DitroniX/CMIS-Current-Monitor-IoT-System/Datasheets and Information/README.md

**CMIS ESP32 Current Monitor IoT Sensors**

------------

This folder contains applicable datasheets and CMIS design information.

Further information can be found:

- **Website** https://ditronix.net/
- **WIKI**  https://ditronix.net/wiki/
- **GitHub**  https://github.com/DitroniX/
- **Shop**  https://ditronix.net/shop/

Dave Williams | G8PUO | DitroniX 1981-2024 | ditronix.net
