DitroniX/CMIS-Current-Monitor-IoT-System/Datasheets and Information/CMIS ESP32 SDK v1 2211-105 PCB 3D Bottom Angled.png

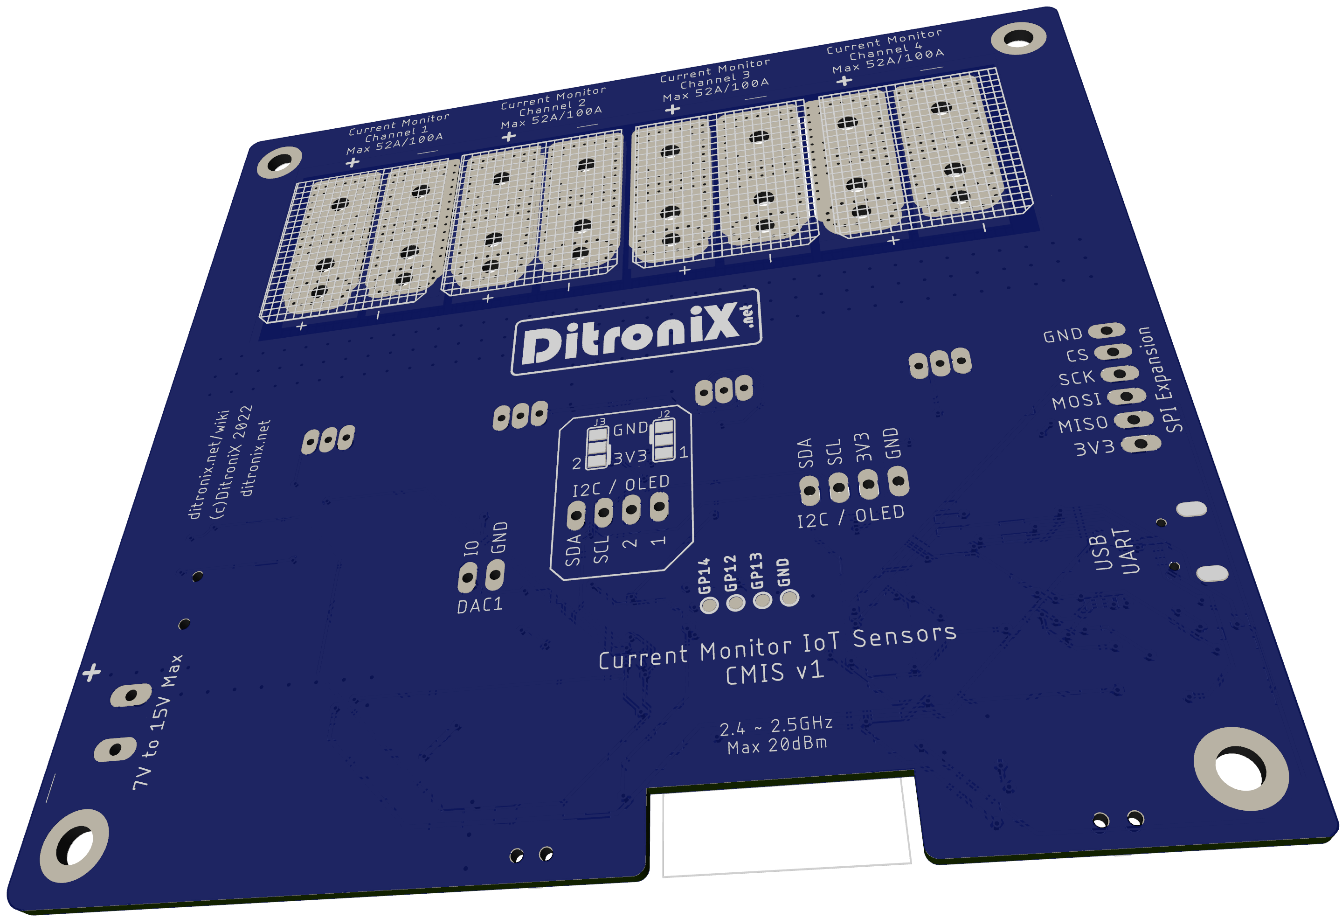
Datasheets and Information/CMIS ESP32 SDK v1 2211-105 PCB 3D Bottom Angled.png
