DitroniX/CMIS-Current-Monitor-IoT-System/Datasheets and Information/CMIS ESP32 SDK v1 2211-105 Schematic.png

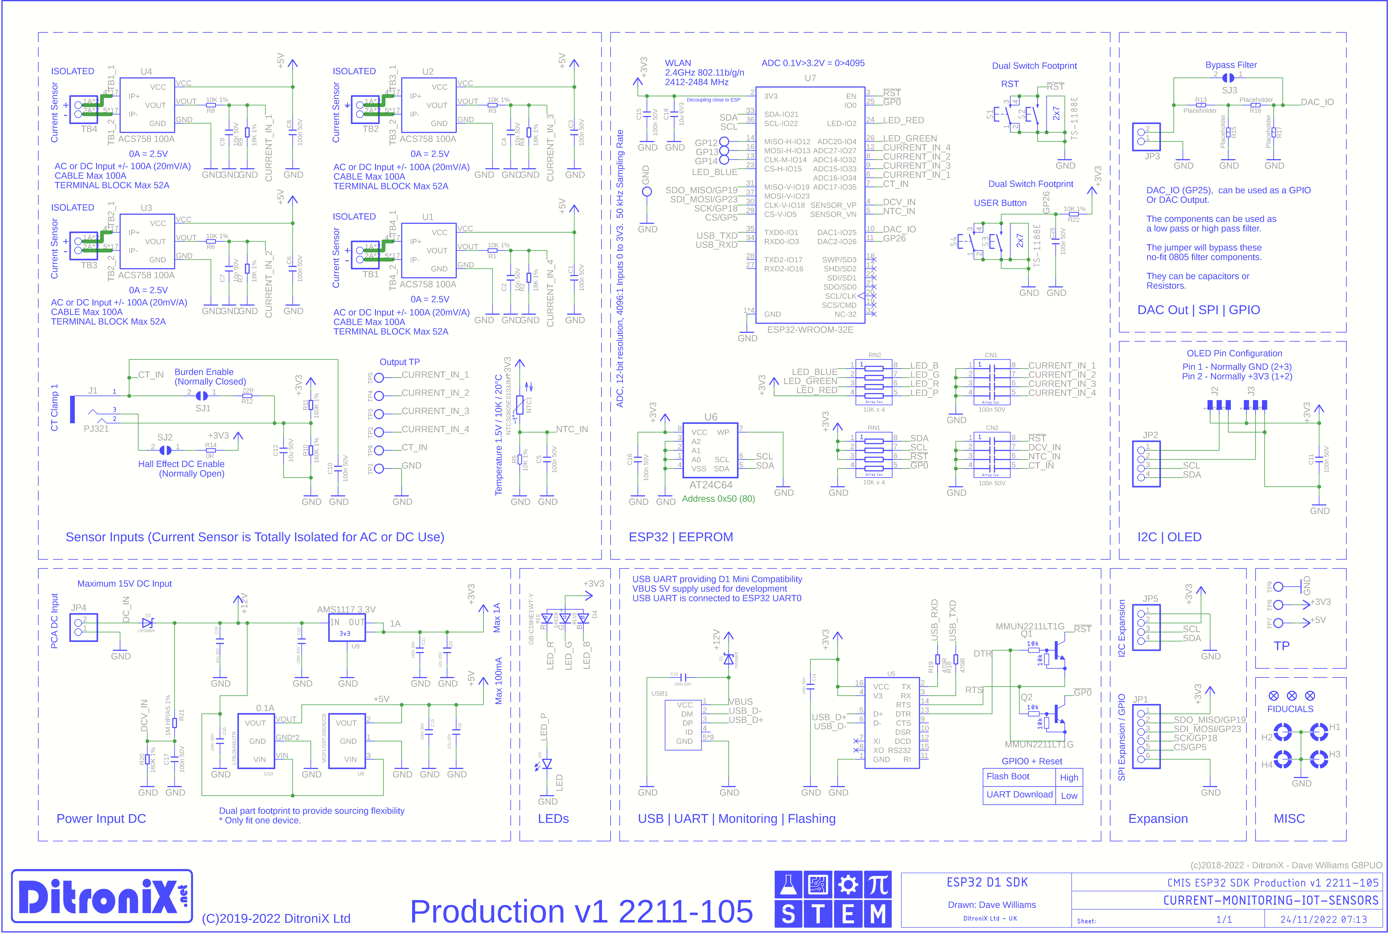
Datasheets and Information/CMIS ESP32 SDK v1 2211-105 Schematic.png
