DitroniX/CMIS-Current-Monitor-IoT-System/DitroniX.net Board Versions and Revisions.txt

For various reasons, our boards may require update.  The below list contains any revision information summary.

Board: CMIS (Current Monitor IoT System)
Features include ESP32, LDO5V, LDO3V3, MODBUS, EEPROM, CT Clamp, AC/DC Multi-Current Sensors, Voltage Sensor, NTC, D1 USB Flashing Compatible

1.2209-102	Beta Release
1.2211-105	Production Release

Further information can be found:

Website https://ditronix.net/
WIKI https://ditronix.net/wiki/
GitHub https://github.com/DitroniX
Shop https://ditronix.net/shop/

Dave Williams | G8PUO | DitroniX 1981-2022 | ditronix.net
